NikolaSl/alt-az-3d-mount/src/assemblies/motion_collision_check.scad

// Reusable diagnostic geometry for automated motion QA.
// Modes 0/1 export boolean intersections; modes 10+ export reusable collision
// meshes for fast Python/FCL state-space sweeps.

include <../config.scad>
use <yoke_stage.scad>
use <../lib/payload_fastener.scad>
use <../parts/alt_gearbox_plate.scad>
use <../parts/alt_gearbox_guard.scad>
use <../parts/payload_clamp_lower.scad>
use <../parts/payload_clamp_upper.scad>
use <../parts/payload_plate.scad>

AZ_ANGLE = is_undef(AZ_ANGLE) ? 0 : AZ_ANGLE;
ALT_ANGLE = is_undef(ALT_ANGLE) ? 0 : ALT_ANGLE;
PAYLOAD_SCREW_Y = is_undef(PAYLOAD_SCREW_Y) ? PAYLOAD_SLOT_CENTER_Y : PAYLOAD_SCREW_Y;
CHECK_MODE = is_undef(CHECK_MODE) ? 0 : CHECK_MODE;
WITH_TABLETOP = is_undef(WITH_TABLETOP) ? false : WITH_TABLETOP;
CLEARANCE_MARGIN = is_undef(CLEARANCE_MARGIN) ? 0 : CLEARANCE_MARGIN;

YOKE_STAGE_Z_QA = AZ_BASE_PLATE_H + AZ_COVER_H + AZ_GLIDE_GAP + AZ_TURNTABLE_H;
SLOT_FLOOR_QA = YOKE_BRIDGE_H - YOKE_SLOT_DEPTH;
ALT_AXIS_Z_QA = YOKE_STAGE_Z_QA + SLOT_FLOOR_QA + YOKE_AXIS_Z;

module alt_drive_to_world_qa(axis_z) {
    multmatrix([
        [0, 0, -1, -(YOKE_INNER_W / 2 + YOKE_ARM_T)],
        [1, 0,  0, 0],
        [0, 1,  0, axis_z],
        [0, 0,  0, 1]
    ]) children();
}

module payload_structural_body_local() {
    // Steel ALT shaft is omitted from this *external* obstruction body because
    // shaft/clamp/bearing engagement is intentional contact. The adjustable
    // screw/knob is exported separately so its full adjustment range can be
    // coupled with ALT rather than hidden inside one default-pose union.
    for (x = [-PAYLOAD_CLAMP_X, PAYLOAD_CLAMP_X]) {
        translate([x, 0, -PAYLOAD_CLAMP_LOWER_H]) payload_clamp_lower();
        translate([x, 0, 0]) payload_clamp_upper();
    }
    translate([0, 0, PAYLOAD_PLATE_Z]) payload_plate();
}

module payload_collision_body_local(payload_screw_y = PAYLOAD_SCREW_Y) {
    payload_structural_body_local();
    payload_fastener_body(y = payload_screw_y);
}

module moving_payload_world(az = AZ_ANGLE, alt = ALT_ANGLE,
                            payload_screw_y = PAYLOAD_SCREW_Y) {
    rotate([0, 0, az])
        translate([0, 0, ALT_AXIS_Z_QA])
            rotate([alt, 0, 0])
                payload_collision_body_local(payload_screw_y = payload_screw_y);
}

module alt_external_obstruction_local() {
    alt_gearbox_plate();
    translate([0, 0, ALT_PLATE_T]) alt_gearbox_guard();
    translate([ALT_MOTOR[0], ALT_MOTOR[1], 0])
        rotate([0, 0, ALT_MOTOR_ROT]) {
            translate([BYJ_BODY_CENTER_FROM_SHAFT[0],
                       BYJ_BODY_CENTER_FROM_SHAFT[1], -BYJ_BODY_H])
                cylinder(d = BYJ_BODY_D, h = BYJ_BODY_H);
            translate([0, 0, -BYJ_FLANGE_T])
                cylinder(d = BYJ_BOSS_D, h = BYJ_BOSS_H + BYJ_FLANGE_T);
        }
}

module fixed_upper_obstructions(az = AZ_ANGLE) {
    rotate([0, 0, az]) {
        translate([0, 0, YOKE_STAGE_Z_QA]) yoke_stage();
        alt_drive_to_world_qa(ALT_AXIS_Z_QA) alt_external_obstruction_local();
    }
}

module expanded_cylinder(d, h, z0, margin) {
    translate([0, 0, z0 - margin])
        cylinder(d = d + 2 * margin, h = h + 2 * margin);
}

module conservative_lower_obstructions(tabletop = WITH_TABLETOP,
                                       margin = CLEARANCE_MARGIN) {
    m = max(0, margin);
    expanded_cylinder(AZ_BASE_D, AZ_BASE_PLATE_H, 0, m);
    expanded_cylinder(AZ_PEDESTAL_D, AZ_PEDESTAL_H, -AZ_PEDESTAL_H, m);
    expanded_cylinder(AZ_BASE_D, AZ_COVER_H + AZ_GLIDE_GAP, AZ_BASE_PLATE_H, m);
    expanded_cylinder(AZ_TURNTABLE_D, AZ_TURNTABLE_H,
                      AZ_BASE_PLATE_H + AZ_COVER_H + AZ_GLIDE_GAP, m);
    if (tabletop)
        expanded_cylinder(TABLETOP_BASE_D, TABLETOP_BASE_T,
            -AZ_PEDESTAL_H - TABLETOP_BASE_T + TABLETOP_LOCATOR_DEPTH, m);
}

module collision_upper(az = AZ_ANGLE, alt = ALT_ANGLE) {
    intersection() {
        moving_payload_world(az = az, alt = alt);
        fixed_upper_obstructions(az = az);
    }
}

module collision_lower(az = AZ_ANGLE, alt = ALT_ANGLE,
                       tabletop = WITH_TABLETOP, margin = CLEARANCE_MARGIN) {
    intersection() {
        moving_payload_world(az = az, alt = alt);
        conservative_lower_obstructions(tabletop = tabletop, margin = margin);
    }
}

if (CHECK_MODE == 0)
    collision_upper();
else if (CHECK_MODE == 1)
    collision_lower();
else if (CHECK_MODE == 10)
    payload_structural_body_local();
else if (CHECK_MODE == 11)
    fixed_upper_obstructions(az = 0);
else if (CHECK_MODE == 12)
    conservative_lower_obstructions(tabletop = WITH_TABLETOP,
                                    margin = CLEARANCE_MARGIN);
else if (CHECK_MODE == 13)
    payload_fastener_body(y = 0);
else
    assert(false, "Unknown CHECK_MODE in motion_collision_check.scad");
