NikolaSl/alt-az-3d-mount/src/parts/gear_alt_motor_12t.scad

use <../lib/alt_reducer20.scad>
alt_motor_pinion_12t();
