NikolaSl/alt-az-3d-mount/src/parts/gear_az_motor_12t.scad

include <../config.scad>
use <../lib/reducer20.scad>
az_motor_pinion_12t();
