NikolaSl/alt-az-3d-mount/src/assemblies/az_reducer.scad

include <../config.scad>
use <../lib/reducer20.scad>
az_reducer_visual();
