NikolaSl/alt-az-3d-mount/src/parts/alt_output_spacer.scad

use <../lib/alt_reducer20.scad>
alt_output_spacer();
