NikolaSl/alt-az-3d-mount/src/parts/gear_alt_compound_48_12t.scad

use <../lib/alt_reducer20.scad>
alt_compound_48_12t();
