NikolaSl/alt-az-3d-mount/src/parts/gear_alt_output_60t.scad

use <../lib/alt_reducer20.scad>
alt_output_60t();
