NikolaSl/alt-az-3d-mount/src/parts/gear_az_compound_48_12t.scad

include <../config.scad>
use <../lib/reducer20.scad>
az_compound_48_12t();
