NikolaSl/alt-az-3d-mount/src/parts/gear_az_output_60t.scad

include <../config.scad>
use <../lib/reducer20.scad>
az_output_60t();
