NikolaSl/alt-az-3d-mount/(list of files, cad)

Other CAD files:
src/parts/yoke_arm_idler.scad
