NikolaSl/alt-az-3d-mount/requirements-qa.txt

matplotlib>=3.8
networkx>=3.2
numpy>=1.26
Pillow>=10.0
scipy>=1.13
trimesh>=4.4
