NikolaSl/alt-az-3d-mount/(commit log)

2026-09-01 Add central OpenSCAD parameters
    [config.scad]
2026-09-01 Add first printable part: azimuth base
    [az_base.scad]
2026-09-01 Implement in-browser OpenSCAD compilation and STL viewer
2026-09-01 Add azimuth gearbox cover and turntable
    Continue the azimuth stage with a printable gearbox cover and rotating platform, using shared interface parameters for the base, cover, output hub and future yoke.
    [az_base.scad, az_gearbox_cover.scad, az_turntable.scad, config.scad]
2026-09-01 Add azimuth reducer stack parameters
    [config.scad]
2026-09-01 Support compound gear axle from cover
    [az_gearbox_cover.scad]
2026-09-01 Add self-contained involute spur gear generator
2026-09-01 Add printable azimuth 20-to-1 reducer
2026-09-01 Add azimuth motor pinion
    [gear_az_motor_12t.scad]
2026-09-01 Add azimuth compound gear
    [gear_az_compound_48_12t.scad]
2026-09-01 Add azimuth output gear
    [gear_az_output_60t.scad]
2026-09-01 Add azimuth reducer assembly view
    [az_reducer.scad]
2026-09-01 Add complete azimuth stage assembly view
    [az_stage.scad]
2026-09-01 Add modular yoke bridge and arm parameters
    [config.scad]
2026-09-01 Add yoke base bridge
    [yoke_base_bridge.scad]
2026-09-01 Add drive-side yoke arm
    [yoke_arm_drive.scad]
2026-09-01 Add idler-side yoke arm
    [yoke_arm_idler.scad]
2026-09-01 Add yoke assembly view
    [yoke_stage.scad]
2026-09-01 Add azimuth plus yoke assembly view
    [az_yoke.scad]
2026-09-01 Add lower payload shaft clamp
    [payload_clamp_lower.scad]
2026-09-01 Add upper payload shaft clamp
    [payload_clamp_upper.scad]
2026-09-01 Add balanced payload plate
    [payload_plate.scad]
2026-09-01 Add 1/4-20 camera screw knob
    [camera_screw_knob.scad]
2026-09-01 Add 8 mm shaft collar
    [shaft_collar_8mm.scad]
2026-09-01 Add altitude payload assembly
    [payload_stage.scad]
2026-09-01 Add full mount with payload assembly view
    [az_yoke_payload.scad]
2026-09-01 Add payload stage parameters after visual QA
    [config.scad]
2026-09-01 Support preview-only QA for large assemblies
2026-09-01 Document full and assembly visual QA modes
2026-09-02 Add single-source assembly guide and hardware BOM
2026-09-02 Link assembly guide as mechanical source of truth
2026-09-02 Add motorized 20:1 altitude drive
    Complete the printable ALT reducer, mount, guard, shaft coupling and full two-axis virtual assembly. Includes updated BOM/assembly instructions and documented visual QA.
    [alt_drive_stage.scad, alt_gearbox_guard.scad, alt_gearbox_plate.scad, alt_output_spacer.scad, config.scad, full_mount.scad, gear_alt_compound_48_12t.scad, gear_alt_motor_12t.scad]
2026-09-02 Expose project state and assembly docs in mobile validator
2026-09-02 Add formal parts decomposition and status ledger
2026-09-02 Integrate parts and interface ledgers into project checkpoint
2026-09-02 Expose parts and interface ledgers in mobile validator
2026-09-02 Add bearing and shaft fit calibration coupon
    [mechanical_fit_coupon.scad]
2026-09-02 Add fastener and nut trap calibration coupon
    [fastener_fit_coupon.scad]
2026-09-02 Add 28BYJ-48 mount and shaft fit coupon
    [byj48_fit_coupon.scad]
2026-09-02 Add physical calibration and measurement procedure
2026-09-02 Publish calibration coupons in browser validator
2026-09-02 Document calibration coupon QA results
2026-09-02 Advance project checkpoint to physical calibration gate
2026-09-02 Expose calibration procedure in mobile validator
2026-09-02 Add shared tabletop base parameters
    [config.scad]
2026-09-02 Add removable tabletop base adapter
    [tabletop_base_adapter.scad]
2026-09-02 Add tabletop base interface context assembly
    [tabletop_base_context.scad]
2026-09-02 Add full mount tabletop review assembly
    [tabletop_full_mount.scad]
2026-09-02 Integrate tabletop base and calibration kit into assembly BOM
2026-09-02 Register tabletop base and validation prints in parts ledger
2026-09-02 Mark core mechanical CAD complete and move to physical verification
2026-09-02 Document tabletop base CAD and context QA
2026-09-02 Parameterize full mount for two-axis motion QA
    [full_mount.scad]
2026-09-02 Propagate AZ and ALT pose parameters to tabletop assembly
    [tabletop_full_mount.scad]
2026-09-02 Add boolean collision diagnostic for motion sweeps
    [motion_collision_check.scad]
2026-09-02 Add automated sampled two-axis motion QA runner
2026-09-02 Optimize collision geometry for dense motion sweeps
    [motion_collision_check.scad]
2026-09-02 Use conservative rotational lower envelope for motion collision proof
    [motion_collision_check.scad]
2026-09-02 Replace Minkowski clearance check with analytic lower-envelope expansion
    [motion_collision_check.scad]
2026-09-02 Add analytic invariant clearance assertions for motion QA
    [motion_clearance_asserts.scad]
2026-09-02 Refactor collision diagnostic for batched pose sweeps
    [motion_collision_check.scad]
2026-09-02 Batch ALT collision poses into single OpenSCAD sweeps
    [motion_collision_sweep.scad]
2026-09-02 Batch collision samples to make motion QA practical in CI
2026-09-02 Expose reusable meshes for fast FCL motion collision QA
    [motion_collision_check.scad]
2026-09-02 Switch motion QA to fast mesh collision and distance sweeps
2026-09-02 Use prebuilt python-fcl wheel for motion QA
2026-09-02 Mark full assemblies motion-QA passed in parts ledger
2026-09-02 Update live assembly guide with accepted full-range motion QA
2026-09-02 Prebuild STL previews and upgrade worker renderer to Manifold
2026-09-02 Prebuild only high-cost assembly previews for mobile
2026-09-02 Bound Pages render cost while keeping instant assembly previews
2026-09-02 Add reusable responsive browser CAD review protocol
2026-09-02 Record responsive mobile CAD rendering architecture
2026-09-02 Prebuild only measured high-cost full assemblies
2026-09-02 Use browser worker rendering as the standard CAD review path
2026-09-02 Record browser-only CAD rendering decision
2026-09-02 Use browser-only CAD rendering on GitHub Pages
2026-09-02 Remove obsolete CI STL preview builder
2026-09-03 Separate payload clamp heights and guarantee knob shaft clearance
    [config.scad]
2026-09-03 Use explicit lower payload clamp height
    [payload_clamp_lower.scad]
2026-09-03 Raise payload plate through upper shaft clamps
    [payload_clamp_upper.scad]
2026-09-03 Parameterize payload screw knob envelope
    [camera_screw_knob.scad]
2026-09-03 Parameterize payload balancing slot datum
    [payload_plate.scad]
2026-09-03 Fix payload knob shaft interference and expose balance position
    [payload_stage.scad]
2026-09-03 Expose payload balance position in full assembly
    [full_mount.scad]
2026-09-03 Expose payload balance position in tabletop assembly
    [tabletop_full_mount.scad]
2026-09-03 Update structural collision body for raised payload plate
    [motion_collision_check.scad]
2026-09-03 Assert payload knob shaft and clamp clearances
    [motion_clearance_asserts.scad]
2026-09-03 Add solid-pair QA adapter for payload balancing travel
    [payload_adjustment_collision_check.scad]
2026-09-03 Add generic solid-body and kinematic-constraint QA protocol
2026-09-03 Centralize physical payload screw and knob QA envelope
2026-09-03 Reuse centralized payload fastener collision envelope
    [payload_adjustment_collision_check.scad]
2026-09-03 Split external payload and adjustable fastener collision bodies
    [motion_collision_check.scad]
2026-09-03 Add browser-reviewable section through payload shaft and fastener
    [payload_adjustment_section.scad]
2026-09-03 Update assembly and BOM for raised payload plate and constraint QA
2026-09-03 Model payload balance as screw-center state with explicit operator yaw constraint
